bigboss0606/captain-Americar/README.md

# captain-Americar

Projet de Alexandre GRIPARI et Robin PERLES Groupe 3

Nous allons créer une voiture contrôler par un gant
