bigboss0606/captain-Americar/Rapports de séance Robin Perles/Séance 5.md

# Rapport séance 4 Robin PERLES

## Chassis
Cette séance, on a encore passé beaucoup de temps sur le chassis, on a vissé le arduino et le module L298H, on a imprimé une planche en bois pour faire un étage.
Je n'ai pas pensé à prendre des photos du résultat.

## Résolution d'un problème majeur
On a réfléchit sur comment envoyé à l'arduino un couple d'entiers pour controler précisément chaque roue et ne plus avoir que 6 directions possibles (pas de marche arrière).
