bigboss0606/captain-Americar/Rapports de séance Robin Perles/Séance 4.md

# Rapport séance 4 Robin PERLES

## Chassis
Hier, on a surtout travaillé sur la partie matériel de la voiture.
On a troué la planche pour accroché les moteurs, et vissé plusieurs composants à la planche.
Je n'ai pas pensé à prendre des photos du résultat.

## Résolution d'un problème majeur
Les modules Bluetooth prenaient longtemps pour s'appairer, et on devait souvent redémarrer la voiture ou l'arduino de l'accéléromètre pour réussir.
Alexandre a trouvé le problème : il faut éteindre et rallumer l'arduino de l'accéléromètre, téléverser le code ne suffit pas.
