bigboss0606/captain-Americar/Rapports de séance Alexandre Gripari/Séance 3.md

# I. Bluetooth / liaison des appareils
Nous avons finalement réussi à faire fonctionner les modules Bluetooth pour mettre en liaison l'accéléroscope et la voiture.

L'erreur était toute simple : en refaisant le circuit j'ai branché le RX de la carte sur le RX du module Bluetooth (de même avec le TX).
Alors qu'il faut brancher le RX avec le TX...
J'ai ensuite modifié le code sur l'accéléromètre pour envoyer des lettres (via Bluetooth) indiquant la direction (ZQSD).

Voici le code: qui a été ajouter au code principale :

```
if ((a.acceleration.x) <= -2){
    Serial.println("Devant");
    BlueT.write("Z");
  }
  if ((a.acceleration.x) >= 2){
    Serial.println("Derrière");
    BlueT.write("S");
  }
  if ((a.acceleration.y) <= -2){
    Serial.println("Gauche");
    BlueT.write("Q");
  }
  if ((a.acceleration.y) >= 2){
    Serial.println("Droite");
    BlueT.write("D");
  }
  Serial.println("------------");
  delay(200);
 ```

# II. Correction de bug / amélioration à faire

On a réalisé plusieurs tests : la voiture peut avancer et tourner, même si la boite coquillette était trop fragile, ce qui avait pour conséquence de pencher les moteurs et les roues.

Pour la prochaine séance, nous aurons sûrement une planche en bois.
Parfois, l'accéléromètre cesse de fonctionner et n'envoie plus de données. Après quelques tests, j'ai découvert que cela était sûrement dû à un fil qui était mal fixé et qui pouvait, quand on faisait bouger le capteur se détacher. En effet si un des fils se déconnecte pendant l'utilisation, même s'il est rebranché après le capteur n'envoie plus de donner.
J'ai donc remplacé ce fil et je n'ai pour l'instant plus eu ce problème.

Enfin puisque par Bluetooth, on ne peut envoyer qu'un message il serait plus intéressant que selon l'inclinaison du capteur, j'envoie un couple de nombres compris entre 0 et 255 ex : 120/255, donnant directement comme information quelle puissance attribuée au moteur A et au moteur B.
Cela permet à l'utilisateur de pouvoir contrôler la vitesse du véhicule en inclinant plus ou moins sa main.
