bigboss0606/captain-Americar/Rapports de séance Robin Perles/Séance 2.md

# Rapport séance 2 Robin PERLES

## Bluetooth
On a essayé de faire marcher les deux modules bluetooth qu'on avait récupéré à la dernière séance : on voulait envoyer des messages d'un moniteur à l'ordre comme dans votre cours mais aucun code n'a marché.
Les modules semblent pourtant bien appareilés : le maître a une led constante et l'esclave clignote toutes les deux secondes.

## Conception chassis
On a ensuite construit un chassis pour la voiture à l'aide d'une boîte de pâtes et de beaucoup de scotch, voir photos et vidéos.
La boite n'est pas assez solide donc le résultat n'est pas top.

## Pour la prochaine fois
On devra rajouter un interupteur pour empecher la voiture de démarrer à chaque fois qu'elle est reliée à un ordinateur ou aux piles.
