bigboss0606/captain-Americar/Rapports de séance Robin Perles/Séance 1.md

# Rapport séance 1 Robin PERLES

## Répartition des tâches
En début de séance, nous nous sommes réparti les tâches : je m'occuperais de la partie voiture et Alexandre s'occupera du gant

## Recherche Internet
J'ai ensuite cherché sur Internet des projets semblables au nôtre.  
J'ai trouvé [ce site](https://passionelectronique.fr/voiture-telecommandee-arduino/) qui montre notamment comment créer le châssis 3D de la voiture.

## Tests sur moteurs à courant continu
J'ai ensuite récupéré deux moteurs à courant continu, un L298 et des piles de l'armoire.  
Le L298 fait la passerelle entre l'Arduino et les moteurs et simplifient leurs utilisations.  
Le L298  
J'ai suivi votre cours pour relier les composants entre eux (ne faites pas attention au joystick):  
Les connections  

Le code source est dans Rapports de séances/Séance 1/testDeuxMoteurs.ino  
Cela marche correctement, les deux moteurs tournent à la bonne vitesse  

## Modélisation 3D
J'ai ensuite voulu commencer le châssis avec Inkscape mais j'ai abandonné car je dois d'abord faire une maquette fonctionnelle.

## Bluetooth
Pour finir la séance, nous avons récupéré deux modules Bluetooth déjà appairés entre eux mais nous n'avons pas eu le temps de les essayer.
