bigboss0606/captain-Americar/Rapports de séance Robin Perles/seance7.md

# Rapport séance 7 Robin PERLES

## Design
Hier, on a surtout travaillé sur la partie matériel de la voiture.
On a travaillé le design de la voiture.
