bigboss0606/captain-Americar/Rapports de séance Robin Perles/Séance 3.md

# Rapport séance 3 Robin PERLES

## Bluetooth
En début de séance, on a réussi à faire communiquer deux ordinateurs par Bluetooth : on peut envoyer un message d'un moniteur à l'autre (on a utilisé votre code et vos branchements).
On a ensuite changé ce code pour que la voiture avance et tourne suivant l'accéléromètre, voir code seance3.ino.
Il nous reste un problème, les modules Bluetooth ont du mal à se connecter et l'accéléromètre semble se bloquer assez rapidement. Cela pourrais être dû à certains fils qui se déconnectent facilement.
Nous regarderons ça à la prochaine séance.

## Conception chassis
Une page se tourne pour la coquillete mobile, en effet la boite de pates n'était pas assez solide. 
On a découpé une planche en bois au Fablab et rajouté deux trous pour accrocher une roue. Le résultat semble plutôt solide.
Nous n'avons pas eu le temps de faire la deuxième.
