bigboss0606/captain-Americar/Rapports de séance Alexandre Gripari/Branchement 2 capteur bluetooth + accéléromètre.JPG

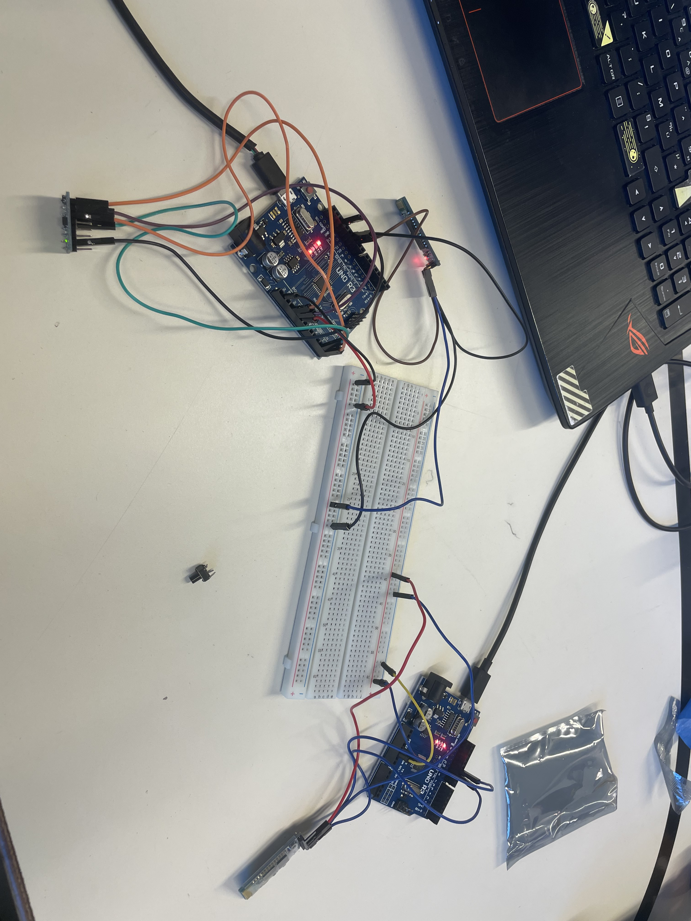
Rapports de séance Alexandre Gripari/Branchement 2 capteur bluetooth + accéléromètre.JPG
