bigboss0606/captain-Americar/Rapports de séance Robin Perles/20230105_232040.jpg

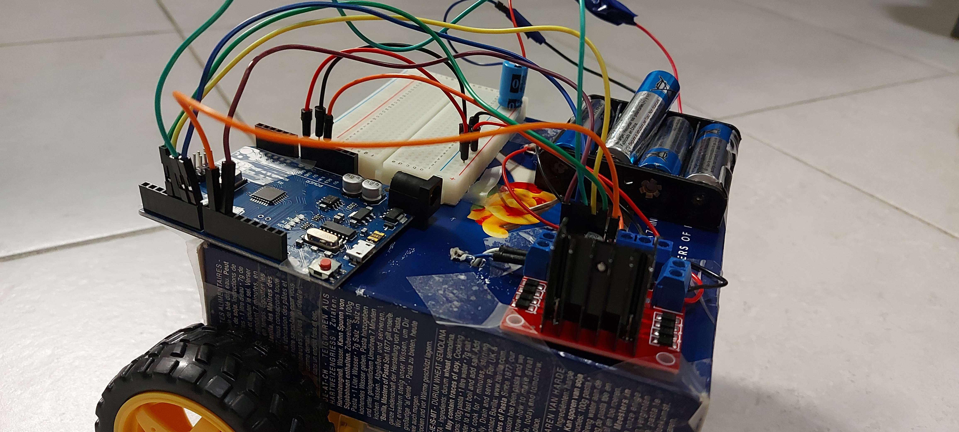
Rapports de séance Robin Perles/20230105_232040.jpg
