bigboss0606/captain-Americar/Ressources/circuit_voiture.png

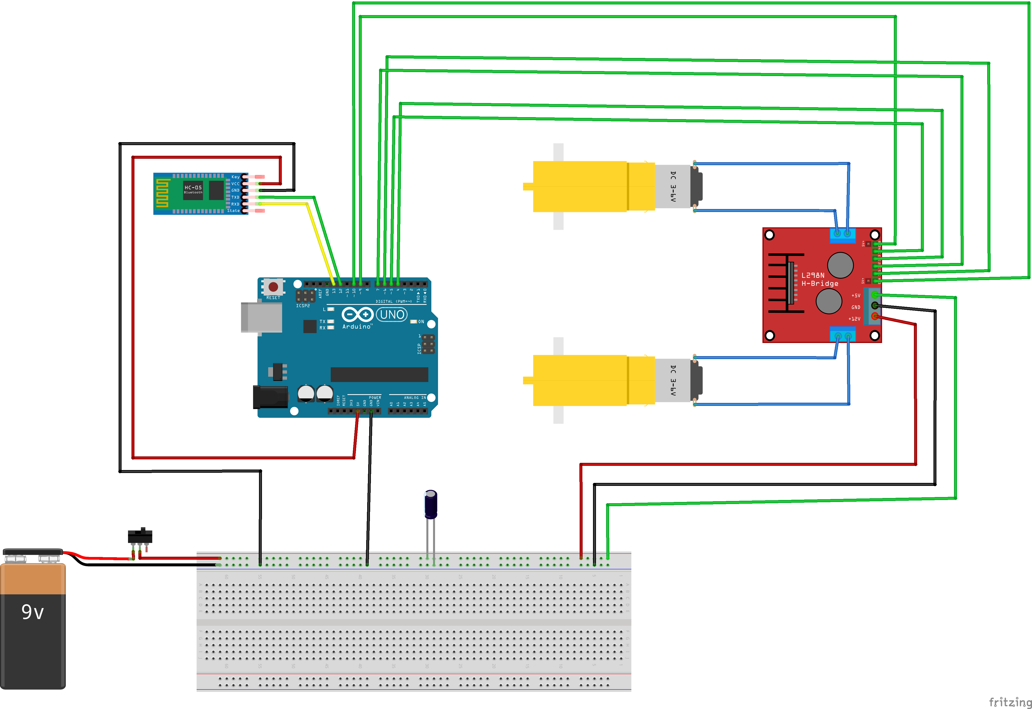
Ressources/circuit_voiture.png
