bigboss0606/captain-Americar/Ressources/Logigramme voiture.png

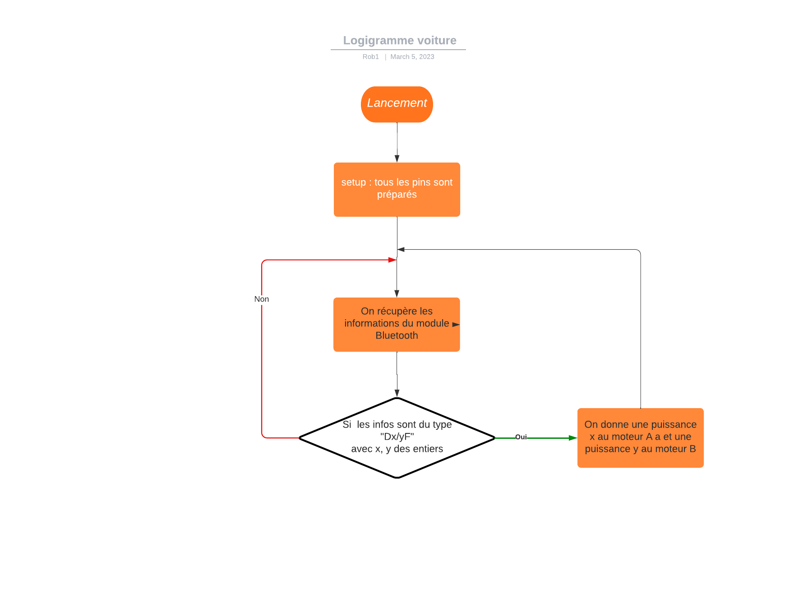
Ressources/Logigramme voiture.png
