bigboss0606/captain-Americar/Ressources/Shema_branchement_gant.jpg

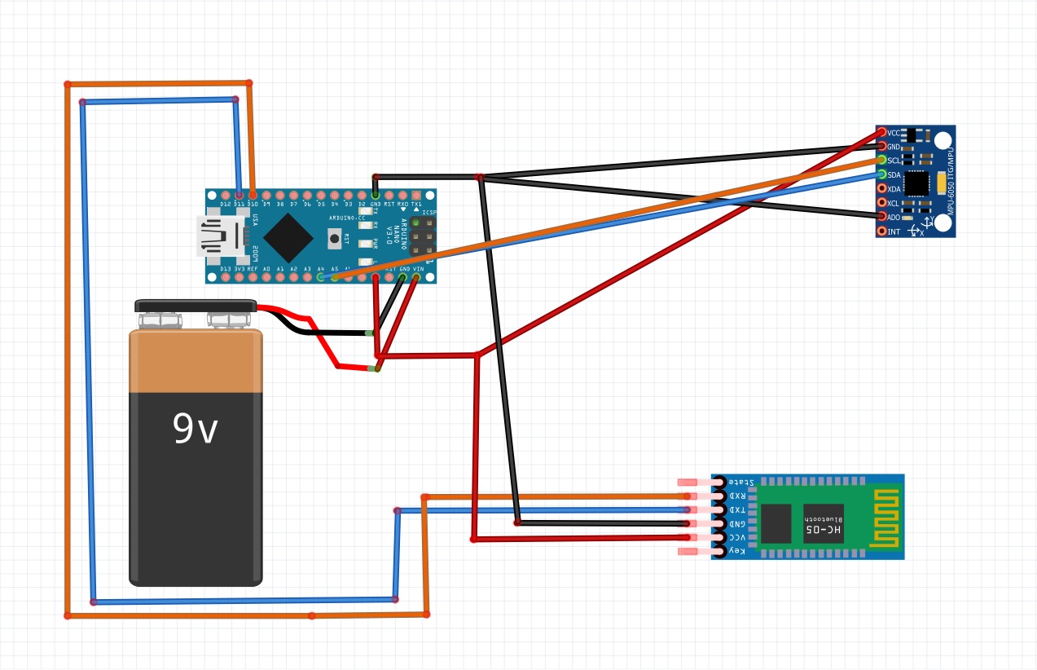
Ressources/Shema_branchement_gant.jpg
