bigboss0606/captain-Americar/Ressources/Voiture_derriere.JPG

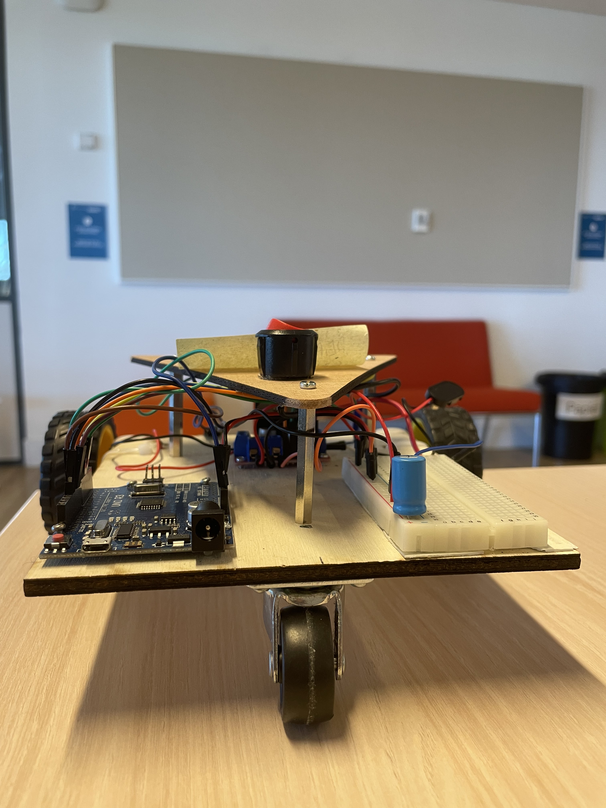
Ressources/Voiture_derriere.JPG
