bigboss0606/captain-Americar/Ressources/Voiture_devant.JPG

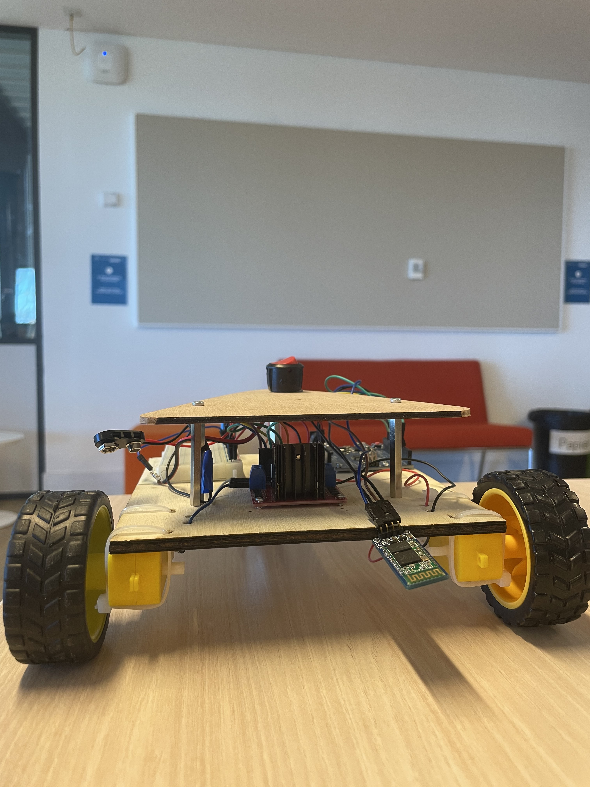
Ressources/Voiture_devant.JPG
