bigboss0606/captain-Americar/Ressources/Arduino.pdf

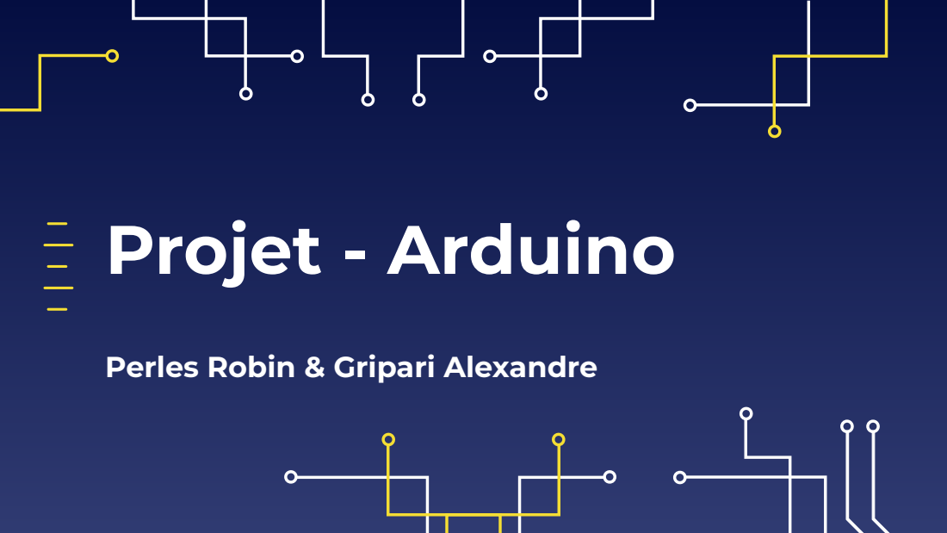
[picture p16: page 1]
Projet - Arduino

Perles Robin & Gripari Alexandre

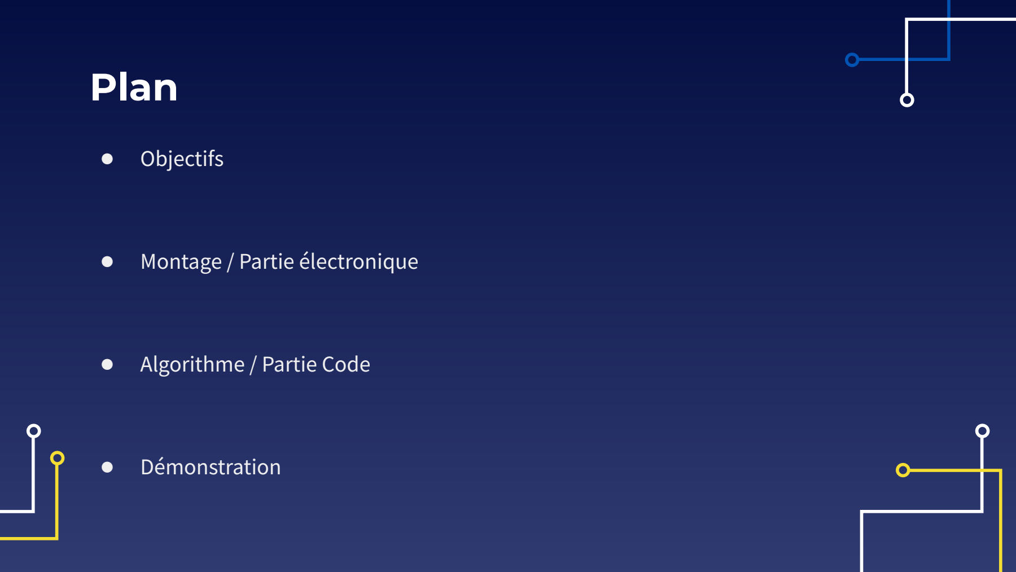
[picture p17: figure]
Plan; ● Objectifs; ● Montage / Partie électronique; ● Algorithme / Partie Code; ● Démonstration

# Objectifs

Le but du projet est de contrôler une voiture à distance à lʼaide dʼun gant.

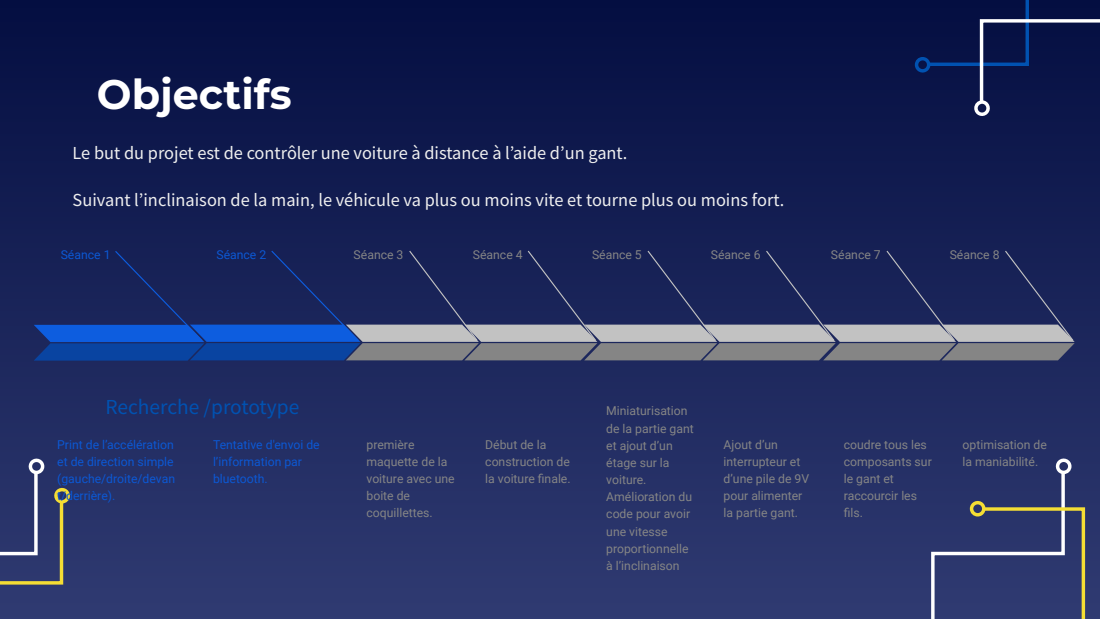
[picture p18: page 3]
Séance 1; Séance 3; Séance 4; Séance 2; Séance 5; Séance 6; Séance 7; optimisation de la maniabilité.; Séance 8; Recherche /prototype

Suivant lʼinclinaison de la main, le véhicule va plus ou moins vite et tourne plus ou moins fort.

Miniaturisation
de la partie gant
et ajout d’un
étage sur la
voiture.
Amélioration du
code pour avoir
une vitesse
proportionnelle
à l’inclinaison

Print de l’accélération
et de direction simple
(gauche/droite/devan
t/derrière).

Tentative d'envoi de
l’information par
bluetooth.

première
maquette de la
voiture avec une
boite de
coquillettes.

Début de la
construction de
la voiture finale.

Ajout d’un
interrupteur et
d’une pile de 9V
pour alimenter
la partie gant.

coudre tous les
composants sur
le gant et
raccourcir les
fils.

# Montage / Partie électronique

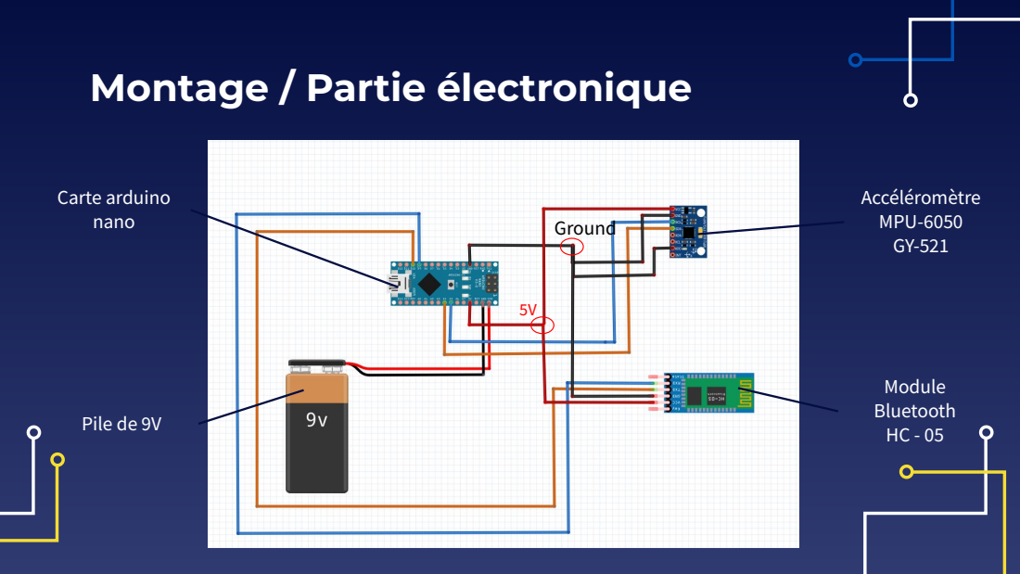
[picture p19: page 4]
Carte arduino nano; Pile de 9V; Accéléromètre MPU-6050 GY-521; Module Bluetooth HC - 05; Ground

# Montage / Partie électronique

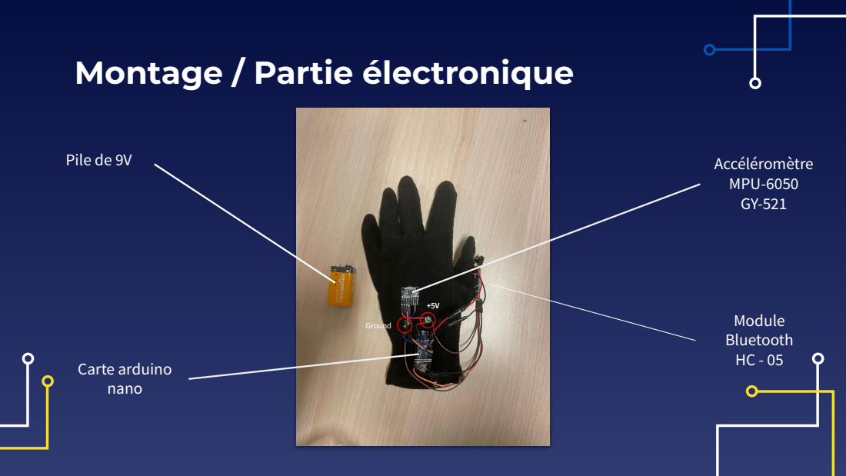
[picture p20: page 5]
Carte arduino nano; Pile de 9V; Accéléromètre; MPU-6050 GY-521; Module Bluetooth HC - 05; Ground

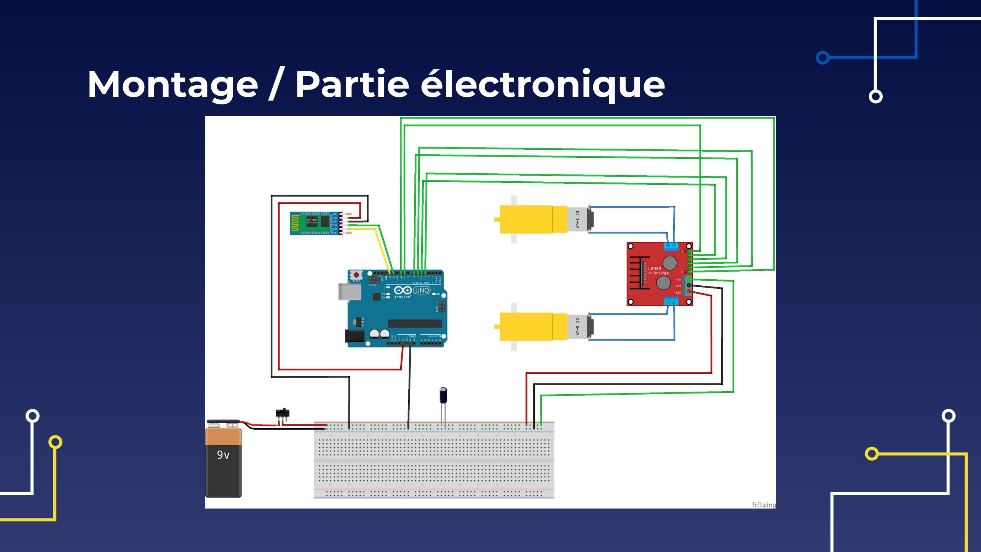
[picture p21: figure]
Montage / Partie électronique

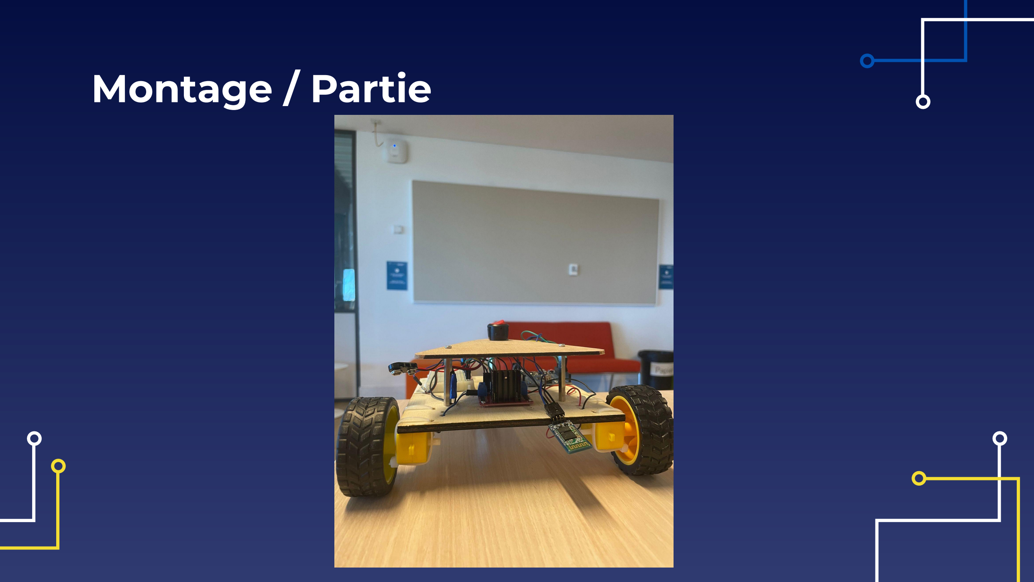
[picture p22: figure]
Montage / Partie

# Algorithme / Partie code

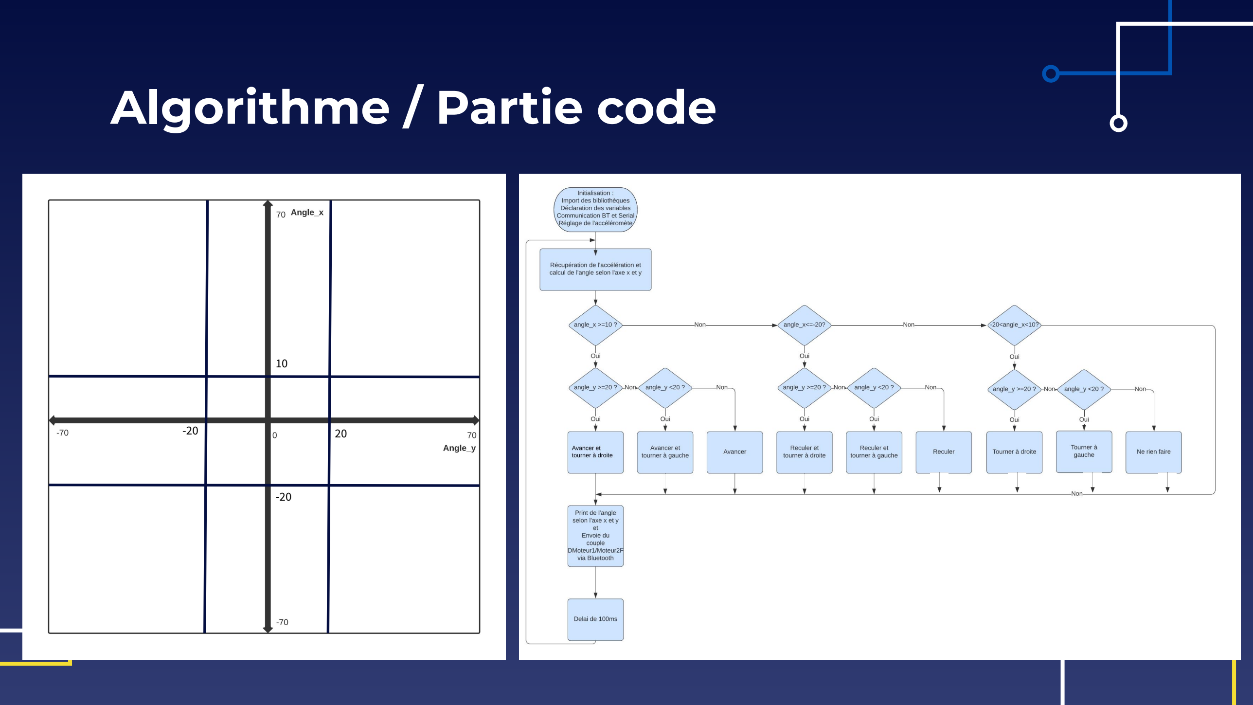
[picture p23: page 8]

-20

-20

10

20

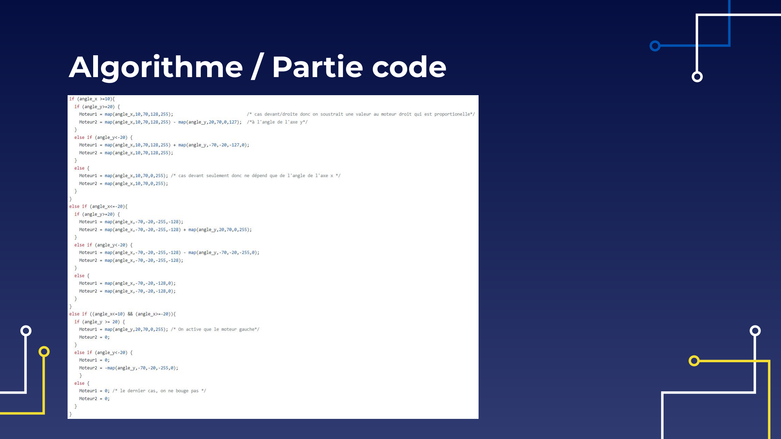
[picture p24: figure]
Algorithme / Partie code

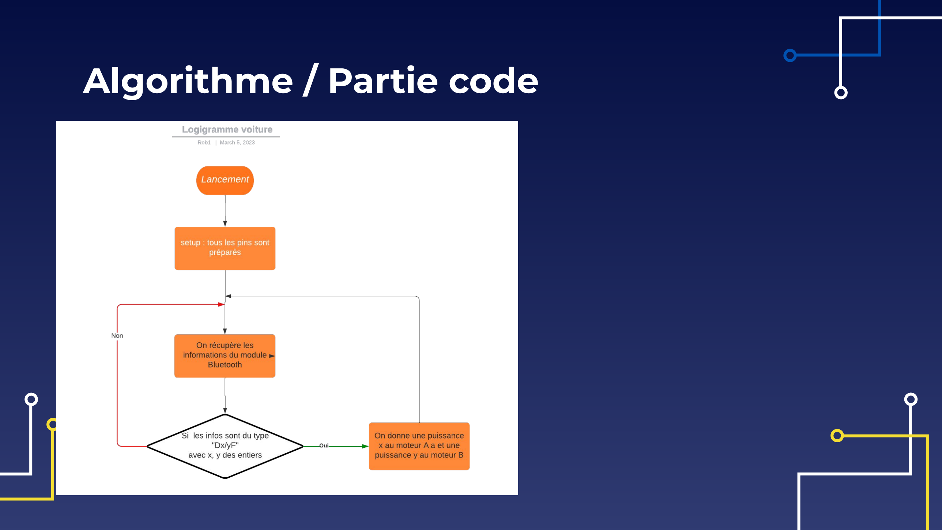
[picture p25: figure]
Algorithme / Partie code
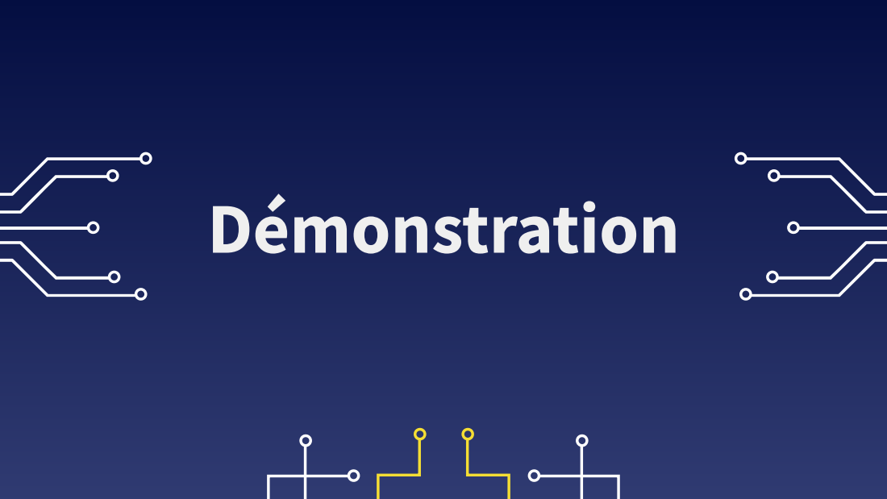
[picture p26: page 11]
Démonstration

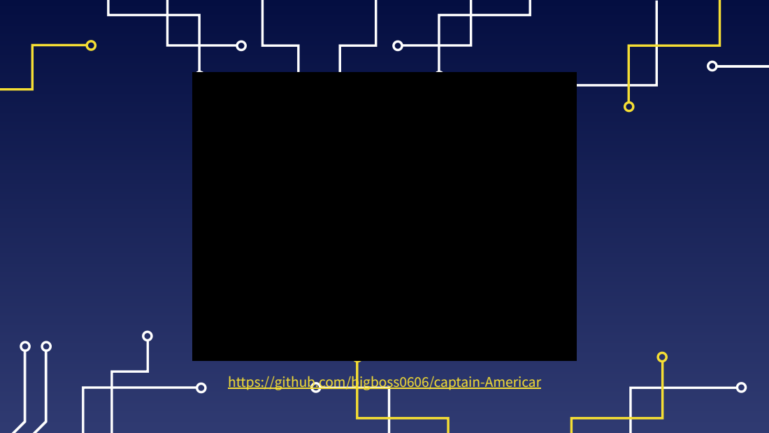
[picture p27: page 12]

https://github.com/bigboss0606/captain-Americar
