bigboss0606/captain-Americar/(commit log)

2022-12-14 Create Cahier des charges
2022-12-16 Create Robin.md
    Rapport de séance 15/12/22
2022-12-16 upload de testDeuxMoteurs.ino
