bigboss0606/captain-Americar/Ressources/Gant.JPG

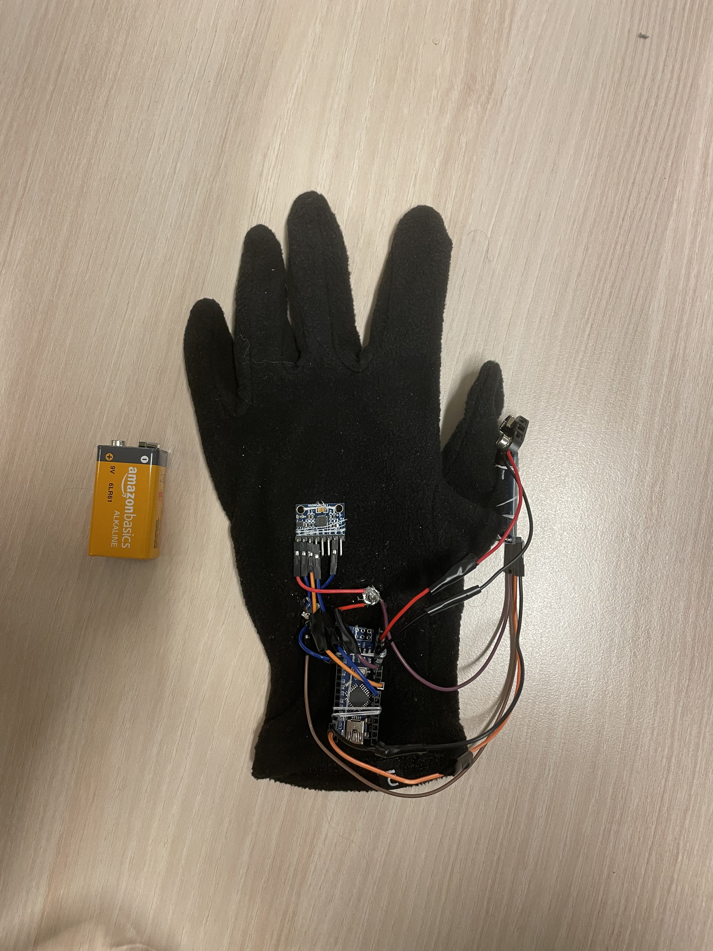
Ressources/Gant.JPG
