bigboss0606/captain-Americar/Ressources/Voiture_dessus.JPG

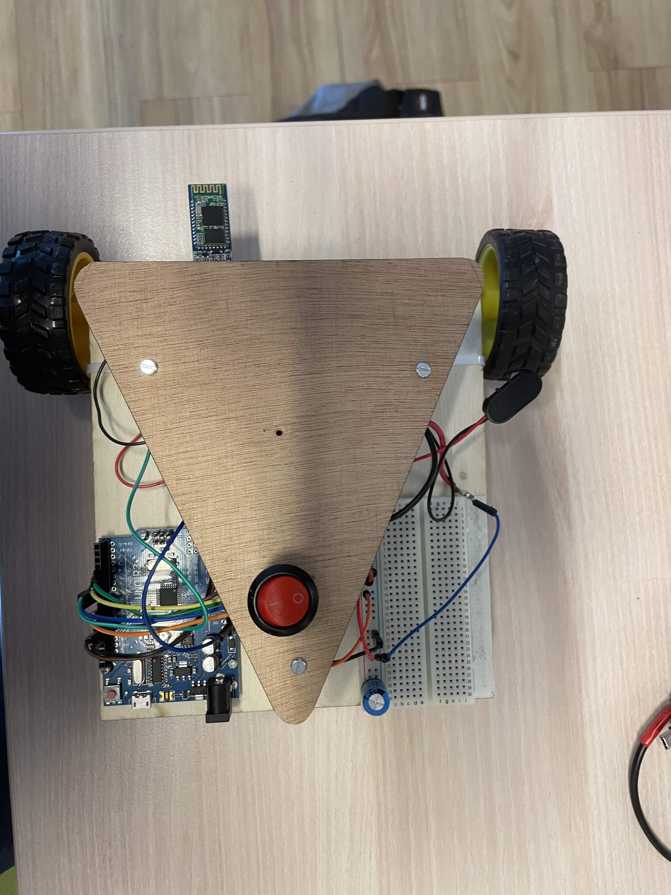
Ressources/Voiture_dessus.JPG
